philipsens/TennisBallBot/documentation/chapters/apendix.tex

\section{Code \& Middelen}

Het volledige project is ontwikkeld via het Git platflorm GitHub. Dit deden we, omdat we er allebei bekend mee waren en omdat de taken goed verdeeld kunnen worden.\\ 

Het project is te vinden op: \url{https://github.com/philipsens/TennisBallBot}

\section{Ontwerp}
De web-applicatie was voorafgaand aan de ontwikkeling ontworpen in Figma. Hier is het design te zien: \url{https://www.figma.com/proto/mFk9zdLfH7LoPvKFsIsM8b/TennisBallBot-WebApp}

\section{Showcase}
Tijdens het project moesten we de andere groepen een showcase van onze prototype laten zien. Deze is te zien op YouTube via deze link: \url{https://www.youtube.com/watch?v=x2dU6p4pzKc}
