philipsens/TennisBallBot/documentation/img/rssi_10cm.png

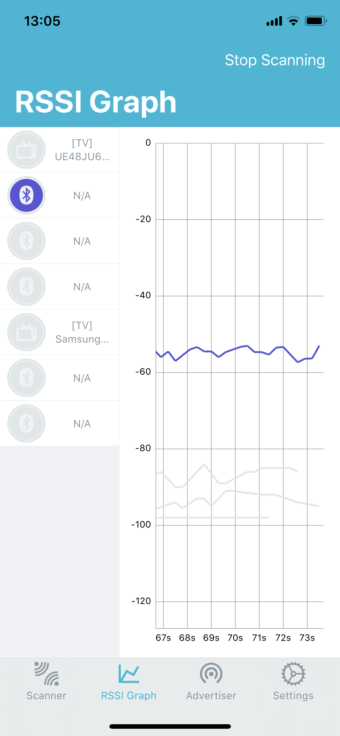
documentation/img/rssi_10cm.png
