philipsens/TennisBallBot/documentation/img/rssi_100cm.png

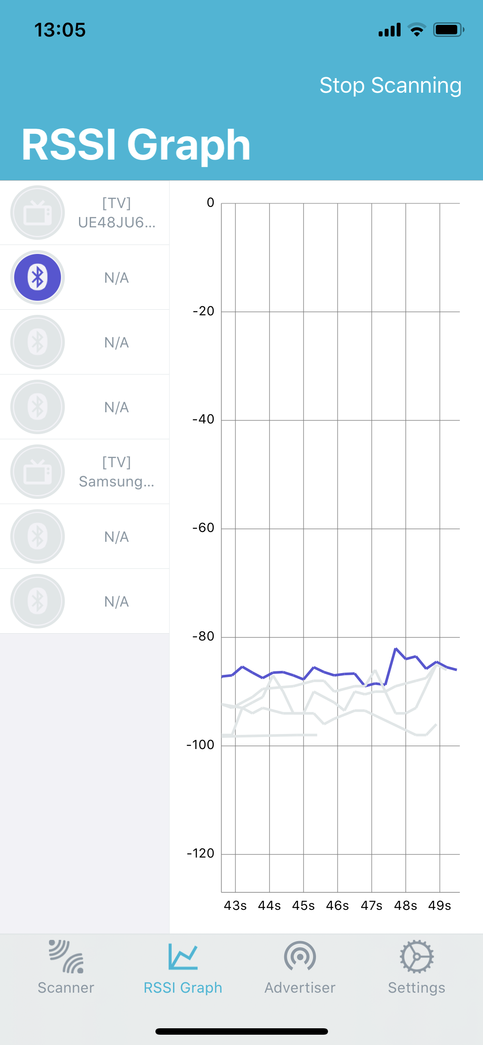
documentation/img/rssi_100cm.png
