philipsens/TennisBallBot/object_detection/images/test_labels.csv

filename | width | height | class | xmin | ymin | xmax | ymax
9k_ (2).jpg | 275 | 183 | tennis_ball | 183 | 84 | 233 | 134
images (1).jpg | 225 | 225 | tennis_ball | 24 | 53 | 134 | 162
images (10).jpg | 267 | 189 | tennis_ball | 41 | 48 | 117 | 123
images (100).jpg | 275 | 183 | tennis_ball | 137 | 50 | 183 | 96
images (11).jpg | 274 | 184 | tennis_ball | 102 | 150 | 118 | 166
images (11).jpg | 274 | 184 | tennis_ball | 121 | 114 | 135 | 130
images (11).jpg | 274 | 184 | tennis_ball | 88 | 102 | 102 | 117
images (11).jpg | 274 | 184 | tennis_ball | 90 | 57 | 100 | 68
images (11).jpg | 274 | 184 | tennis_ball | 172 | 33 | 181 | 42
images (11).jpg | 274 | 184 | tennis_ball | 81 | 35 | 89 | 43
images (11).jpg | 274 | 184 | tennis_ball | 99 | 24 | 106 | 32
images (11).jpg | 274 | 184 | tennis_ball | 136 | 1 | 141 | 4
images (11).jpg | 274 | 184 | tennis_ball | 26 | 8 | 31 | 14
images (11).jpg | 274 | 184 | tennis_ball | 52 | 26 | 62 | 37
images (11).jpg | 274 | 184 | tennis_ball | 20 | 43 | 30 | 54
images (12).jpg | 263 | 192 | tennis_ball | 57 | 55 | 120 | 116
images (12).jpg | 263 | 192 | tennis_ball | 125 | 40 | 223 | 140
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
