philipsens/TennisBallBot/(threads)

Thread 6 (2020-06-03):

Ballen naar het verzamelpunt brengen

0xJ0EY, 2020-06-03:
- [x] Defineer start-/verzamelpunt

- [x] Maak gebruik van BLE voor de huidige positie

- [x] Duw de ballen zorgvuldig naar het verzamelpunt

Requiers #19

Closed 2020-07-10.

Thread 19 (2020-06-19):

Logica voor het verzamelpunt, zones en modus maken maken

philipsens, 2020-06-19:
De robot moet weten in welke modus deze is. Deze zijn:
* Terug naar verzamel punt (en niks verzamelen)
* Verzamelen binnen de zones
* Overal verzamelen

Het verzamelpunt en ze zone moet geselecteerd kunnen worden. Dit is gerelateerd met issue #16

Closed 2020-07-10.
