philipsens/TennisBallBot/(commit log)

2020-06-04 Added Zumo shield design
    [zumo_mount.scad]
2020-06-05 Add trained model Add train images and config
    [test_labels.csv, train_labels.csv]
2020-06-09 Fixed the beacons and added a very basic scanner for the raspberry pi
    [beacon.ino]
2020-06-10 You can now use parameters to set the correct version
    The first param is the major
    The second param is the minor
    [beacon.ino]
2020-06-16 Add tennis ball detection script Add scrips for installing dependencies Rename object detection folder to object_detection
    [test_labels.csv, train_labels.csv]
2020-06-17 Add hard negavites as its own class
    [test_labels.csv, train_labels.csv]
2020-06-17 Remove a for loop by implementing the width and position into the detection object Also print the nearest detection
2020-06-18 Parse UART input for commands
    You can now send a command like
    "left=100" to set the left track at a speed of 100.
    Its also possible to combine the commands like
    "left=100;right=200".
    Now the only thing to do is implement honking
2020-06-21 Fixed bug with parsing the string
    The strtok function uses a shared buffer, if you overwrite this
    buffer at a later function, you'll get some unexpected output when
    trying to use the original one. This can be fixed by using strtok_r
    [zumo.ino]
2020-06-22 Big refactor
    [test_labels.csv, train_labels.csv]
2020-06-22 Add readme for install instructions on the raspberry pi
2020-06-25 Bump pyxdg from 0.25 to 0.26 in /raspberry
    Bumps [pyxdg](https://github.com/takluyver/pyxdg) from 0.25 to 0.26.
    - [Release notes](https://github.com/takluyver/pyxdg/releases)
    - [Changelog](https://github.com/takluyver/pyxdg/blob/master/ChangeLog)
    - [Commits](https://github.com/takluyver/pyxdg/compare/rel-0.25...rel-0.26)
2020-06-28 Start the webserver with the API when starting the program
    It is now possible to access the backend api with the following url:
    <raspberry-ip>:5000/api/zone
2020-06-29 Flip the frame so the detections happen in the right orientation
2020-06-29 Bump urllib3 from 1.24.1 to 1.24.2 in /raspberry
    Bumps [urllib3](https://github.com/urllib3/urllib3) from 1.24.1 to 1.24.2.
    - [Release notes](https://github.com/urllib3/urllib3/releases)
    - [Changelog](https://github.com/urllib3/urllib3/blob/master/CHANGES.rst)
    - [Commits](https://github.com/urllib3/urllib3/compare/1.24.1...1.24.2)
2020-06-29 Refactor, mainly for less duplicate code
    [zumo_mount.scad]
2020-06-30 Redid the Zumo api interface
    Now it works with a lock instead of a queue + thread
2020-07-02 Add a failsafe for the zumo if there hasn't been a new command for two seconds
    [SerialManager.cpp, SerialManager.h]
2020-07-02 Fixed imports & fixed if statement
    [SerialManager.cpp, SerialManager.h]
2020-07-02 Add requirements for the PID controller
2020-07-07 Fixed return ball state
    [zumo.ino]
